joranderaaff/portal-turret-v4/README.md

# Portal Turret v4

A Portal-style turret powered by an ESP32-S3 (Lolin S3 Mini). It detects people with a mmWave radar, opens its wings, extends its guns and tracks targets, complete with sound and lights.

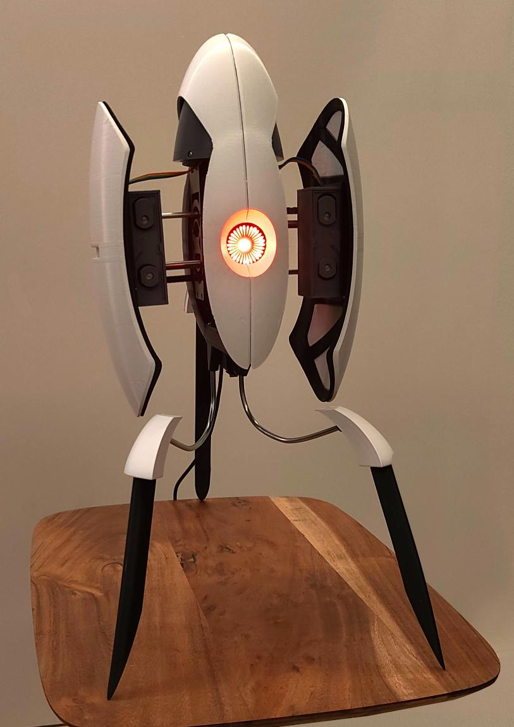
[picture p1: images/photo.jpg]
Portal Turret




## Repository layout

| Folder | Contents |
| --- | --- |
| `src/` | Firmware (PlatformIO, Arduino framework) |
| `data/` | LittleFS image: audio clips and web UI |
| `3d/` | 3D model (`model.step`) |
| `gerber/` | PCB manufacturing files (MainBoard, DaughterBoard) |
| `images/` | Build guide photos |

## Bill of materials

### Printing
- PLA (Or other material) in white, black and optionally transparent.

### Electronics
- Lolin Wemos S3 Mini
- 4x SG90 180 servo
- 2x SG90 360 servo
- LD2450 Radar Sensor
- ADXL345 Digital 3-axis Accelerometer Module
- MAX98357 Audio amp
- 2x OH49E Hall Effect Sensor - SS49E compatible
- SN74AHCT125N 4-channel Level Converter
- SK6812 Digital 5050 RGB LED Ring
- 5x WS2812 5mm LED
- Small rocker switch
- USB C Breakout Board, 12 * 15 * 1.6mm
- 2x 100nF Ceramic Capacitor 
- 1x 100uF 25V Elektrolytic Capacitor

### Motion
- 604ZZ Ball Bearing - 4x12x4mm
- MYT LM6LUU Linear Ball Bearing - 2 pieces (35mm length)
- 4mm steel rod
- 6mm steel rod

### Cables
- JST PH crimp set OR JST PH headers and pre-crimped JST PH cables
- Pin headers

### Fasteners
- 2mm wood screws
- Super Glue

## Steel Rod Sizes

For the 4mm rods:
- 1x 150mm (enforcing the rear leg)
- 2x 55mm (enforcing the front legs)
- 2x 60mm (wings)
- 1x 43mm (x-axis axle)
- 1x 20mm (z-axis bottom axle)
- 1x 10mm (z-axis top axle)

The bended rods for the legs do not have a very precise length. It's best to bend and cut to length after bending, as this makes the process of getting the correct shape a lot easier.

For the 6mm rods:
- 2x 60mm (wings)

## 3D printing

STEP file contains all 3D printed parts.

[All STL files can be found here.](https://www.printables.com/model/1892132-portal-turret-mk-ii)

## Electronics

Gerber files are included. Order from your favorite PCB manufacturer.

### Pinout

ESP32-S3 GPIO numbers, defined in `src/pins.h`.

| Function | GPIO |
| --- | --- |
| Left / right gun servo | 1 / 2 |
| Left / right wing servo | 4 / 5 |
| Rotate X / Z servo | 6 / 7 |
| Left / right hall sensor (analog) | 8 / 9 |
| Eye LED ring (center) / left gun LEDs / right gun LEDs | 14 / 15 / 16 |
| Radar (ESP RX / ESP TX) | 17 / 18 |
| ADXL345 I2C (SDA / SCL) | 35 / 36 |
| Audio amp I2S (DIN / BCLK / LRCLK) | 10 / 11 / 12 |

### Power

The turret runs on 5 V, from the USB-C board or the power connector. The servos, LED ring, audio amp and radar all share it, so use a supply that can deliver at least 2 A. That figure is a rule of thumb for six SG90 servos plus the LEDs, not a measured value.

## Preperation

The 180 degree servos might not be centered when you purchase them. Make sure you to do this with a servo tester or writing a small Arduino sketch that centers your servos. If you don't have an Arduino board to do this, you could even use the Wemos in a breadboard and use some wires to hook up a servo to calibrate them.

Use the hall sensor to find out what the north and south pole of your magnets are. You'll need to know this to make sure you insert them correctly later in the build.
Again you can use the Wemos to test. Using a breadboard, hook up the sensor to 3.3V, Gnd and one of the analog pins. Read the analog value. When the north pole faces the sensor, the value should increase. If it's the south pole, it should decrease.

## Assembly guide

Here's raw screenshots. Explicit information comes later.

### X axis

| Notes | Images |
| --- | --- |
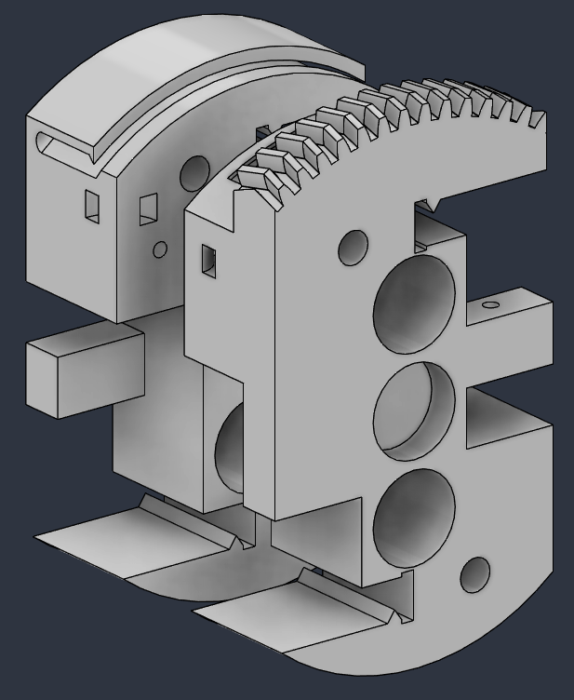
[picture p2: images/x_axis_001.png]
X axis 2
| Screw the two halves together. |  |
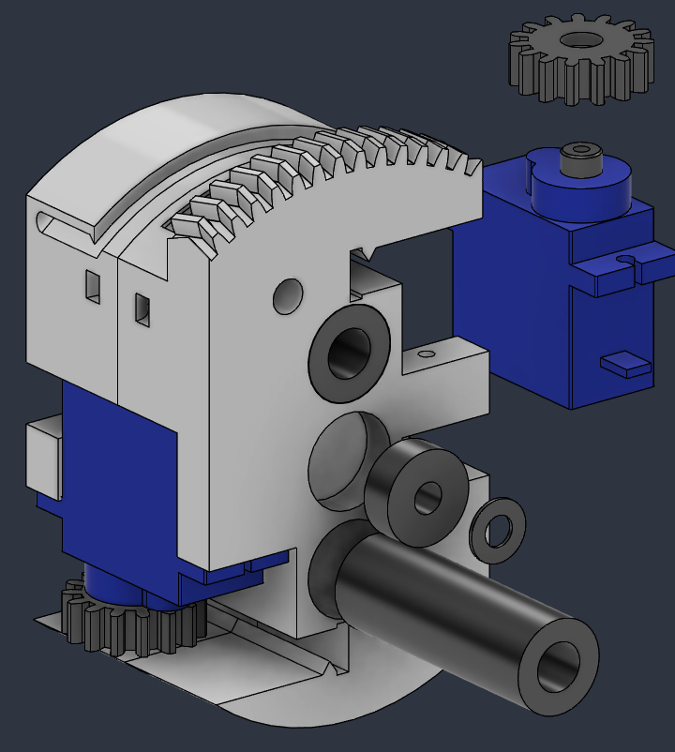
[picture p3: images/x_axis_002.png]
X axis 2
| Insert the LM6LUU and 604ZZ bearings. Screw the gears on the two 360 servos. |  |
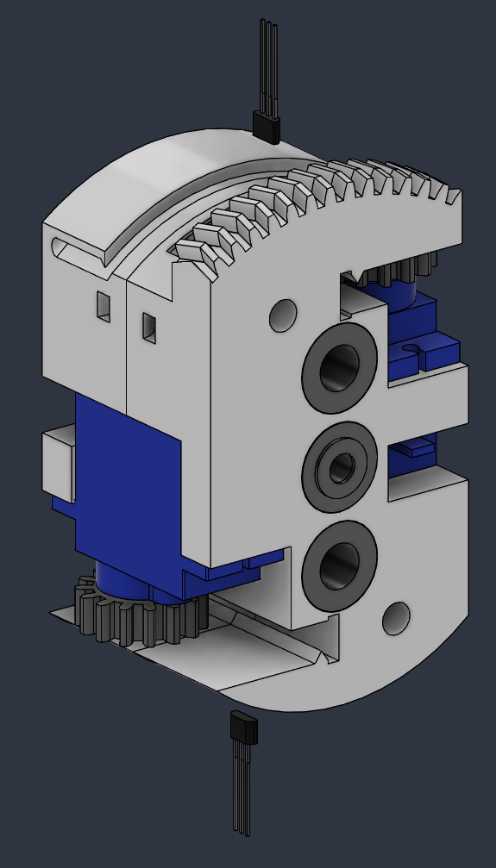
[picture p4: images/x_axis_003.png]
X axis 3
| Solder the wires to the hall sensors. Use shrink tubing to protect the leads. Insert the hall sensors into the slots. The beveled face is the front and should point towards the space where the rack gears will slide. |  | 
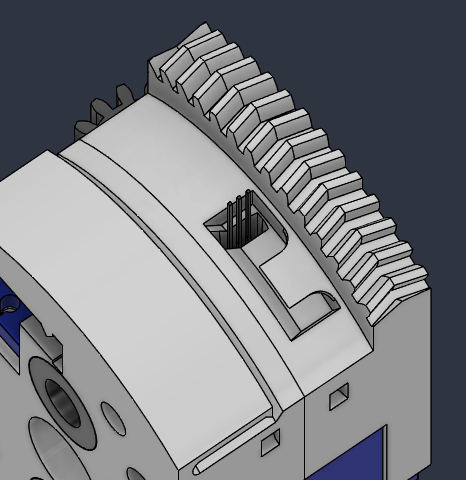
[picture p5: images/x_axis_004.png]
X axis 4
| Tuck the wires underneath the little lip. This should help with keeping the hall sensors in place. If they don't want to stay seated, a drop of superglue should help. |  | 

### Z axis
| Notes | Images |
| --- | --- |
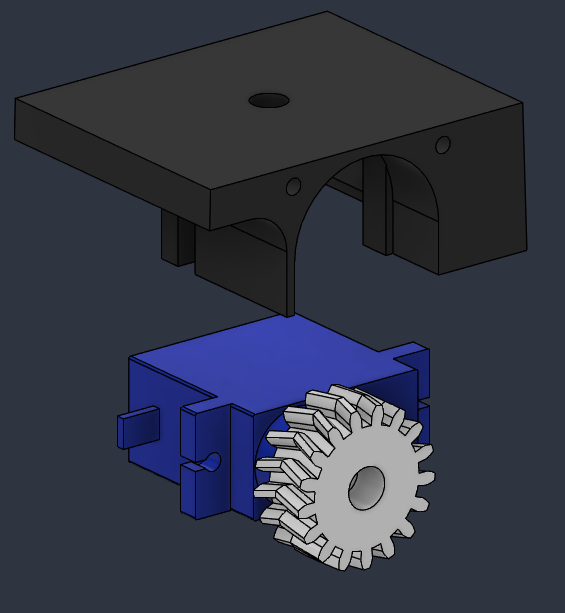
[picture p6: images/z_axis_001.png]
Z axis 1
| Screw on the X Axis gear on a 180 servo. Slide it in place and use the channels to screw it down. |  |
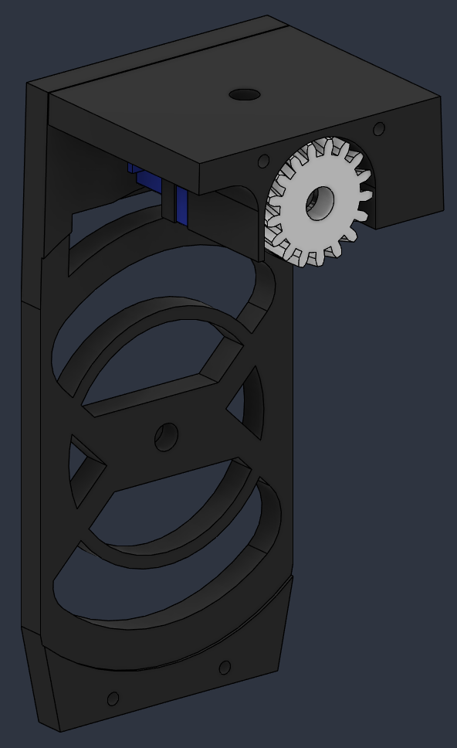
[picture p7: images/z_axis_002.png]
Z axis 2
| Attach one side. |  |
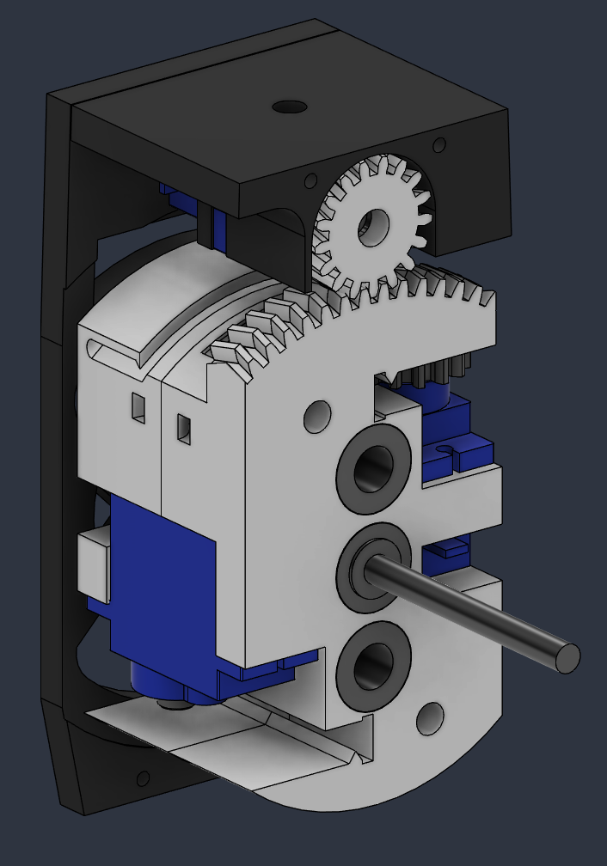
[picture p8: images/z_axis_003.png]
Z axis 3
| Slide a 4mm rod through the X axis. Add a 4mm shim on both sides. There is a slot in the frame where the rod should fit. |  |
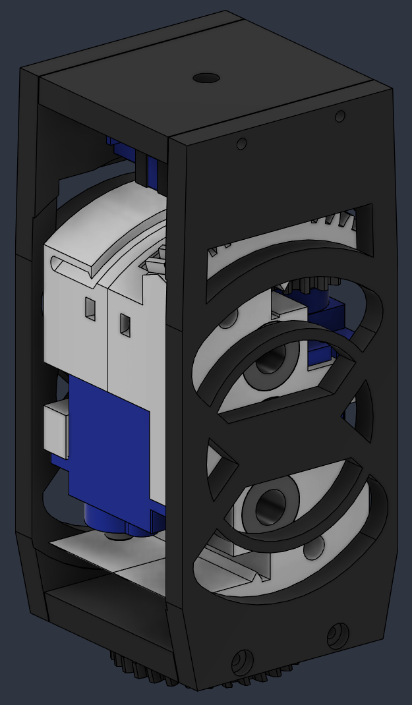
[picture p9: images/z_axis_004.png]
Z axis 4
| Scew on the bottom and the other side. |  |
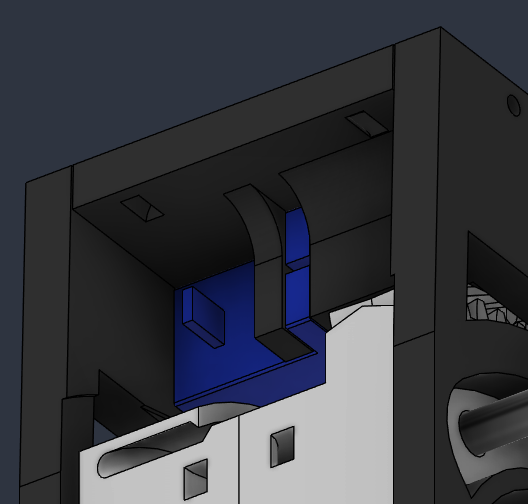
[picture p10: images/z_axis_005.png]
Z axis 4
| Use a ziptie to manage all cables. It should hold the following wires: 2 Hall sensors, 2 Wing servos, X Axis servo. |  |

### Bottom
| Notes | Images |
| --- | --- |
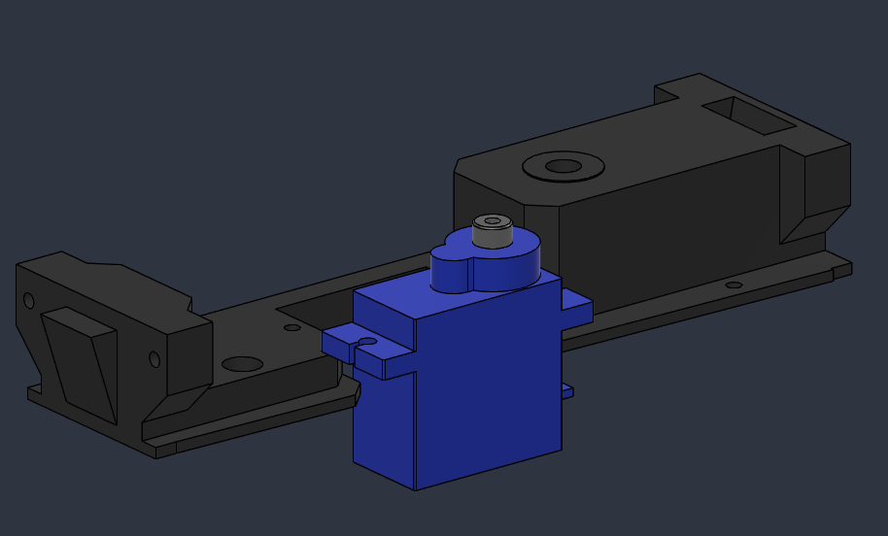
[picture p11: images/bottom_001.png]
Bottom 2
| Slide a 180 servo in the mount and screw it secure |  |
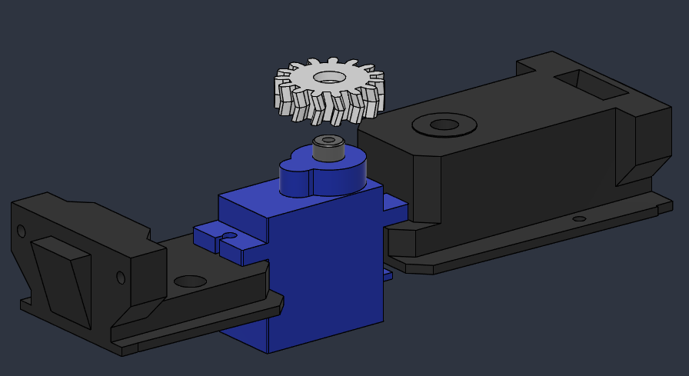
[picture p12: images/bottom_002.png]
Bottom 2
| Screw on the Z Axis gear. |  |
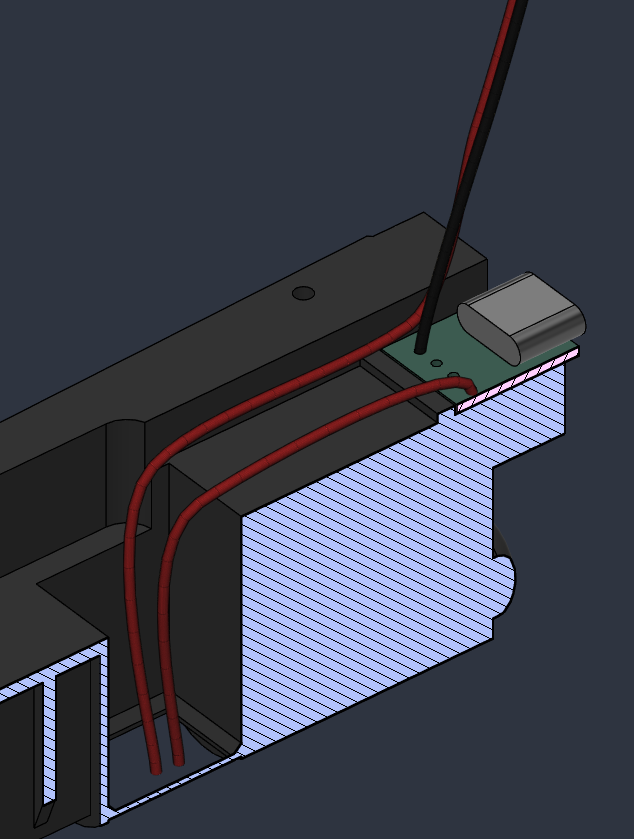
[picture p13: images/bottom_003.png]
Bottom 2
| The USB-C board should be glued into place. If you can't get a solid connection with glue, a tiny screw with some heatshrink could be screwed through the D- slot. Make sure the screw does not short D- to ground, hence the heatshrink tubing. Run the wires through the bottom. Make sure to leave enough to route the wires and attach the JST connector. |  |
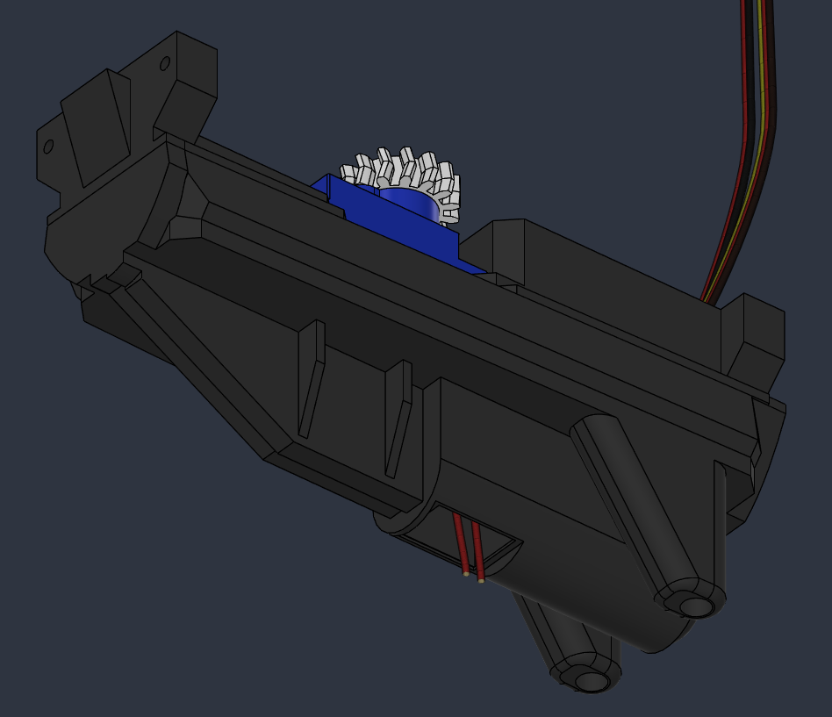
[picture p14: images/bottom_004.png]
Bottom 2
| Route the two 5V wires to the bottom. One should come from the USB board, the other should go to your power connector. |  |
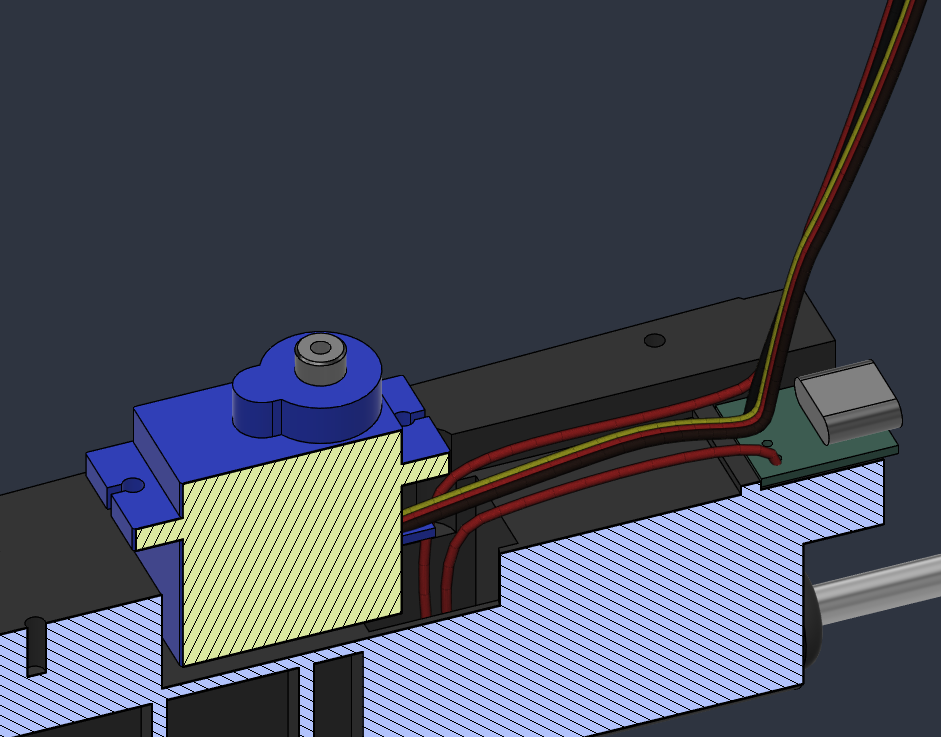
[picture p15: images/bottom_005.png]
Bottom 2
| The servo wires should also be run through the same channel to go up in the back. |  |
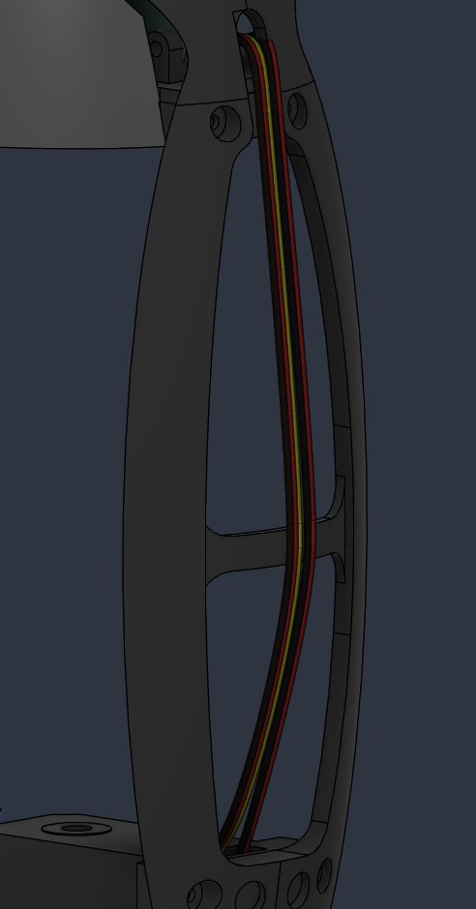
[picture p16: images/bottom_006.png]
Bottom 2
| Run both the servo and power wires through the gantry. Use the little brace to keep them out of the way from the gantry.  |  |

### Eye
| Notes | Images |
| --- | --- |
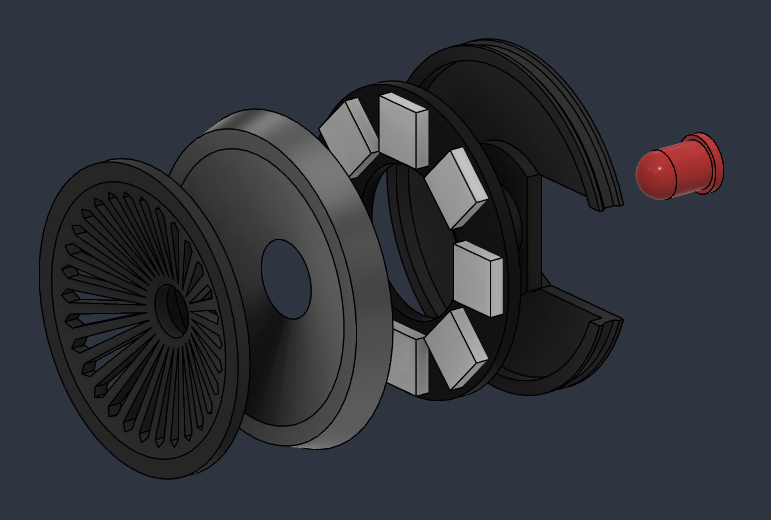
[picture p17: images/eye_001.png]
Eye 1
| Print the flat retina and mold. As PLA gets soft at relatively low temperatures, you can dunk it in boiling water and press it on the mold for the correct shape. Make sure to print the diffuser with very little top/bottom layers and walls, or use transparent filament. Glue in the LED ring and 5mm LED. Bend the 5V and Gnd legs of the LED to the pads of the ring and solder them together. The `D-in` leg should go to the `D-out` pad. Run 3 wires to the `D-in` `5V` and `Gnd` pads of the LED Ring. Keep enough length to run it through the turret. Add a JST connector when you're sure you have enough length. |  |

### Gantry

| Notes | Images |
| --- | --- |
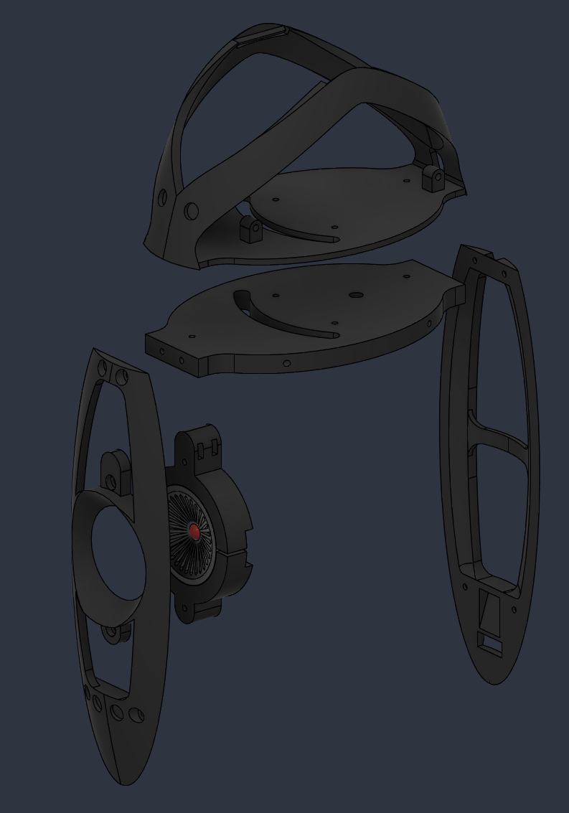
[picture p18: images/gantry_001.png]
Gantry 1
| The gantry consists of 5 different pieces. This is done so you can print with little to no support material. The eye should click in place and stay there without any glue. |  |
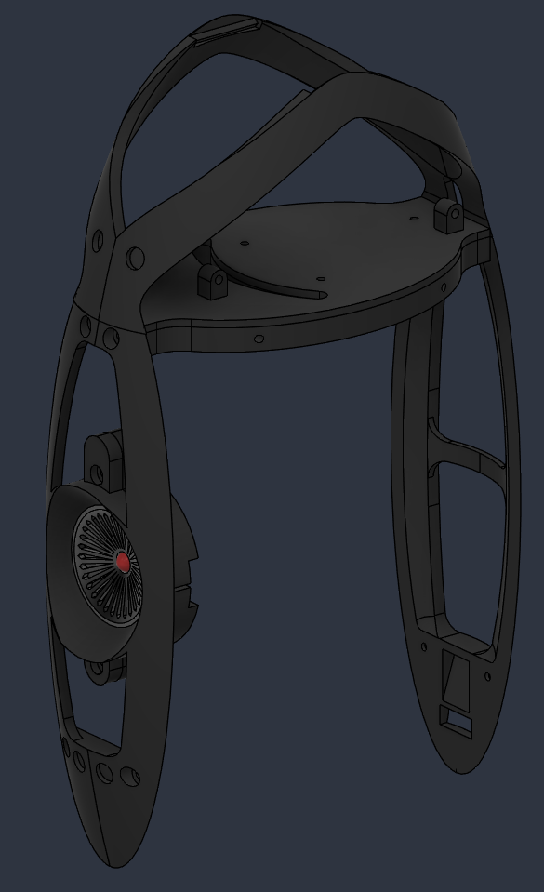
[picture p19: images/gantry_002.png]
Gantry 2
| The whole gantry should screw together and give enough rigidity for the build. |  |
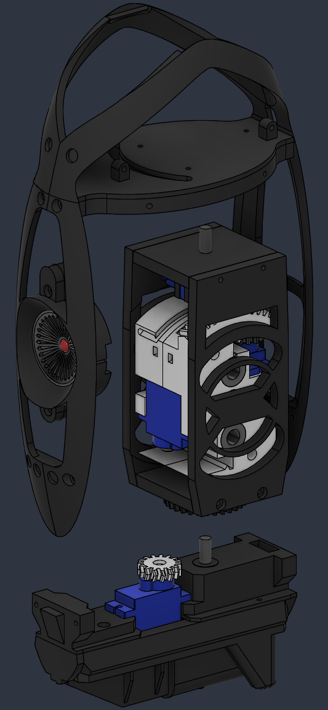
[picture p20: images/gantry_003.png]
Gantry 3
| Slide in the gantry and bottom. Make sure to not rotate your servo when assembling, otherwise you'll risk a very big offset in angle. You can calibrate small offsets in the settings. |  |
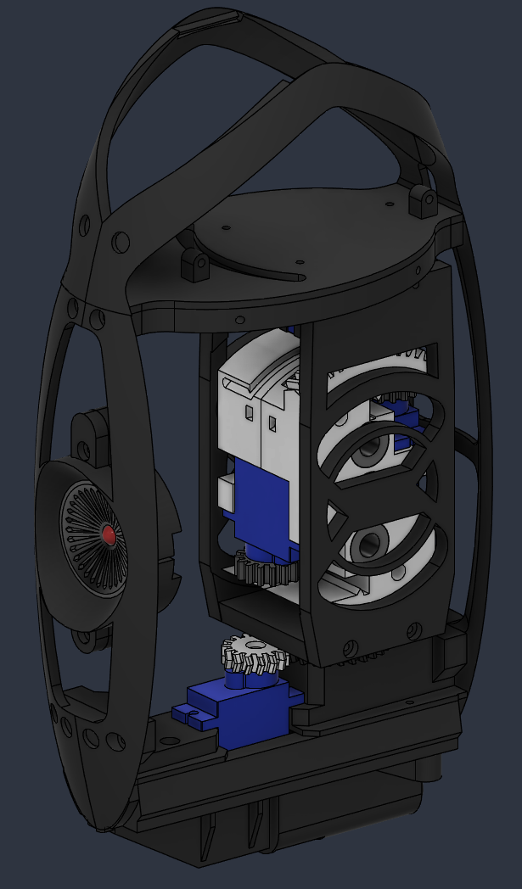
[picture p21: images/gantry_004.png]
Gantry 3
| Screw in the last screws on the front and back of the gantry to finish the motion system. |  |

### Guns

| Notes | Images |
| --- | --- |
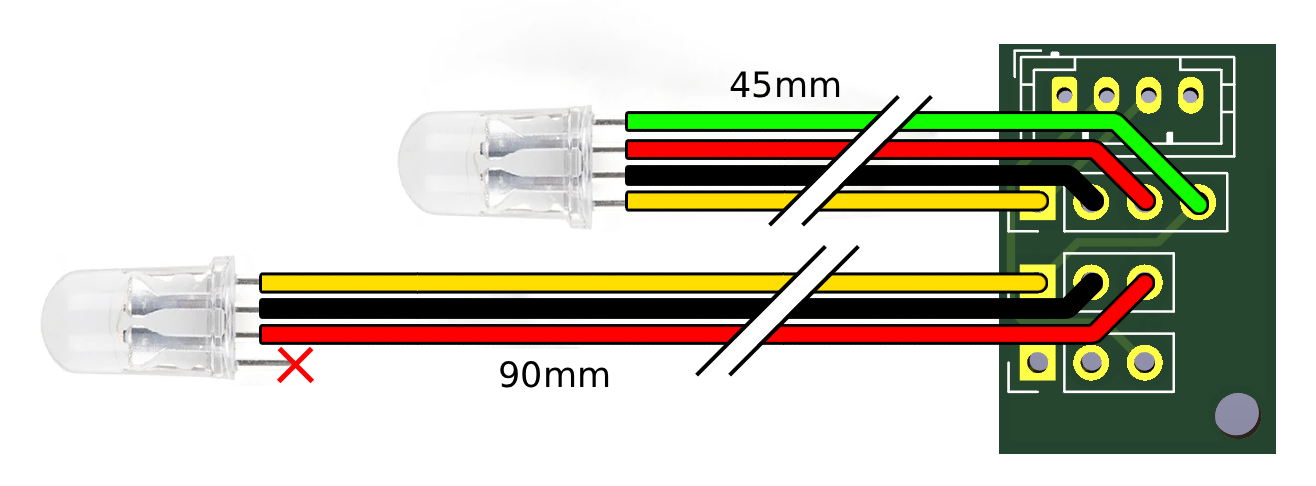
[picture p22: images/led_harness.png]
| Prepare the LED harness. You can either use JST connectors or solder directly to the board. Make sure you double check the pads of the board and the legs of your LEDs. I've found that different brands can have a different order in the legs. Please note that the `Data In` leg should go to the `Data In` pad, NOT the `Data Out` pad. |  |
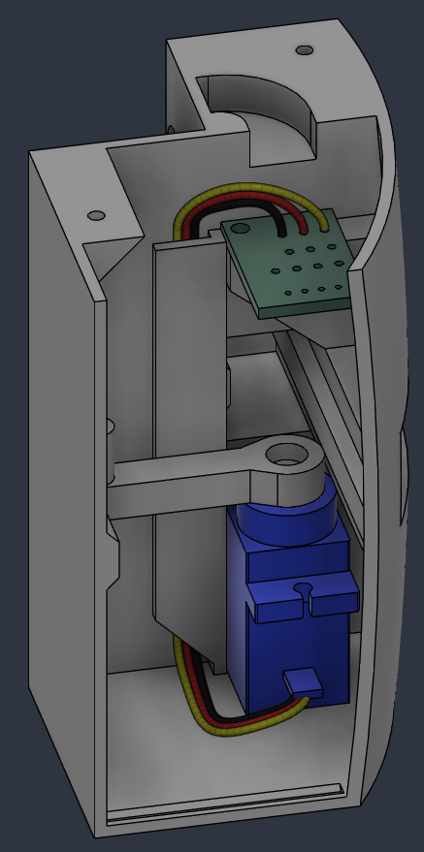
[picture p23: images/gun_001.png]
| Attach the lever to a 180 servo. The lever should be a friction fit. Insert it into the gun casing and run the wire as shown. Note that the LED harness is not shown here, but should already be attached to the board. |  |
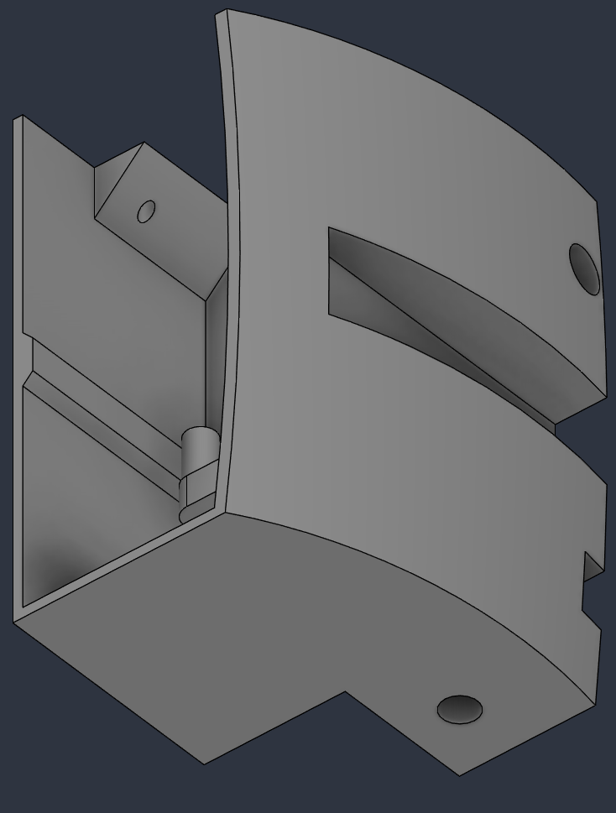
[picture p24: images/gun_002.png]
| There's a hole in the bottom to fasten the servo with a screw. |  |
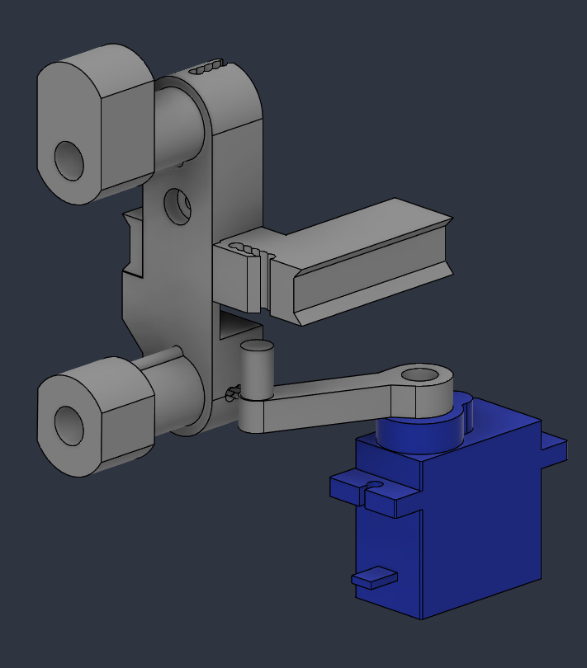
[picture p25: images/gun_003.png]
| Insert the barrels into their housing. This should be a friction fit. The housing screws on the part with one screw. |  |
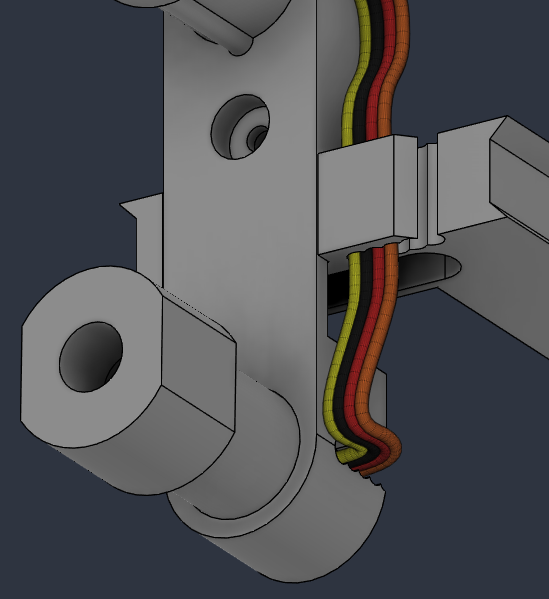
[picture p26: images/gun_004.png]
| Slide in the bottom LED and run the wires to the side and through the clamp in the front. |  |
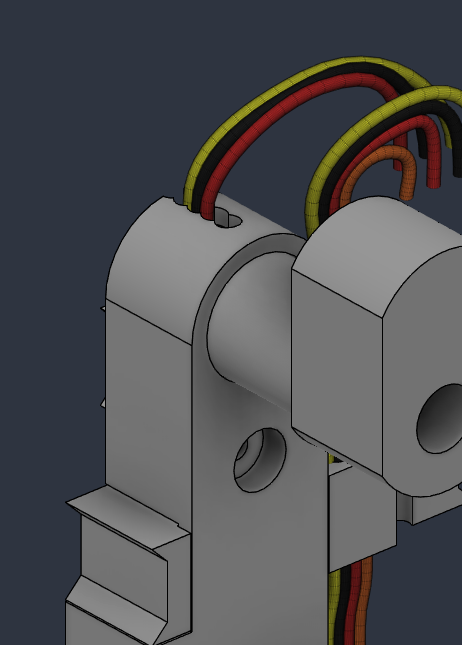
[picture p27: images/gun_005.png]
Gun 3
| Slide in the top LED and run the wires out the top. |  |
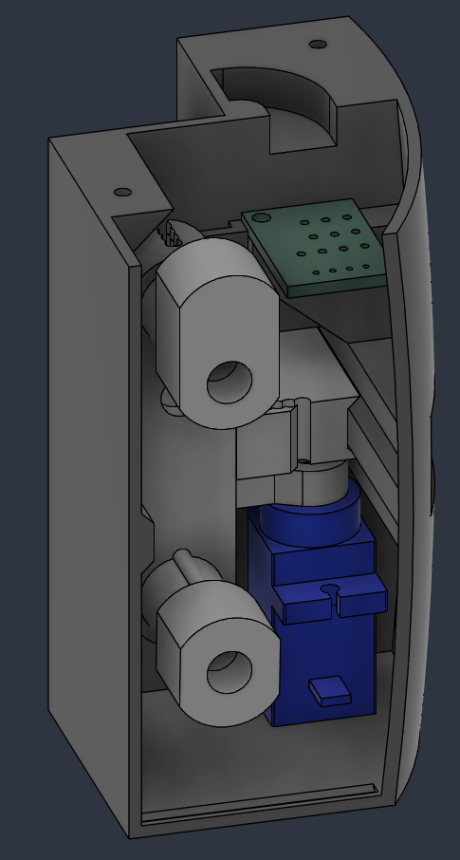
[picture p28: images/gun_006.png]
Gun 4
| Rotate the lever so it points forward. |  |
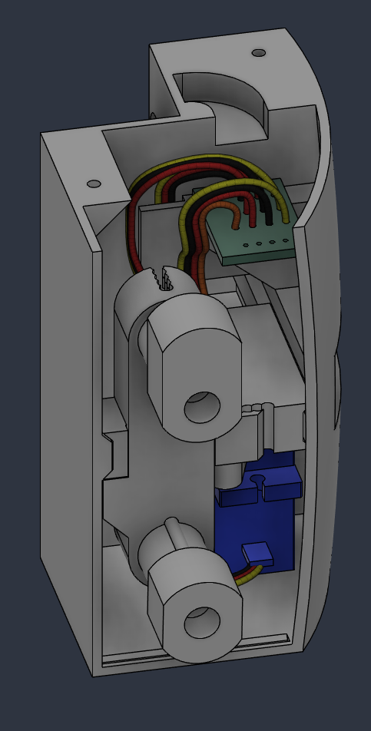
[picture p29: images/gun_007.png]
Gun 5
| Carefully slide the barrels over the lever. You might need to bend the housing to get it in place. Note that the pictures shows the wires outside of the clamps, this is a render error. |  |
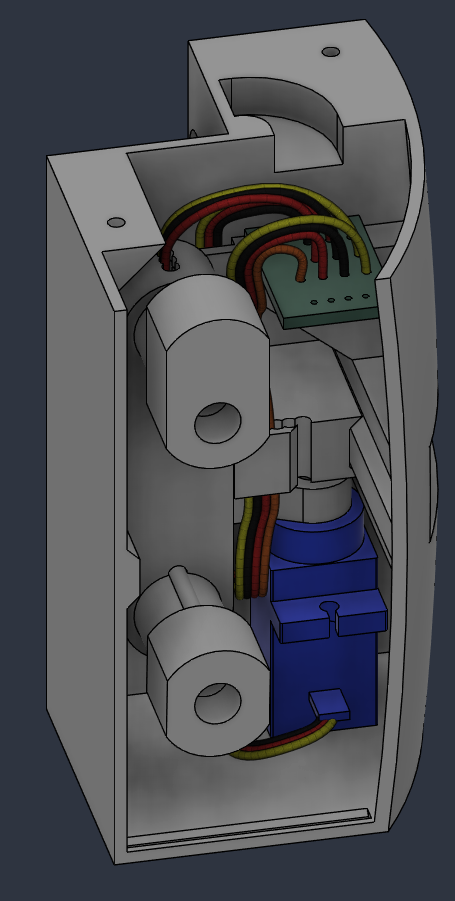
[picture p30: images/gun_008.png]
| Slide the barrels back into the housing. They should slide easily. If not, try to move the lever by hand. If the barrels don't move, check the clearance of your parts. |  |
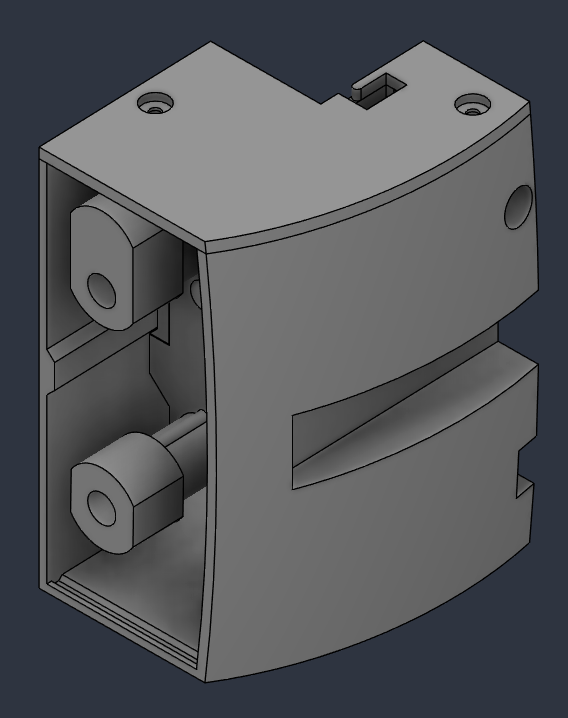
[picture p31: images/gun_009.png]
| The top can now be screwed on. |  |
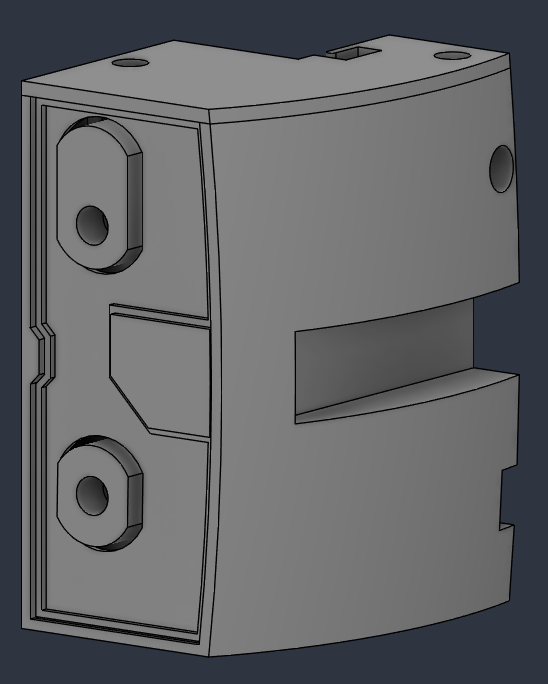
[picture p32: images/gun_010.png]
| The front plate should click in place. |  |

### Wings

| Notes | Images |
| --- | --- |
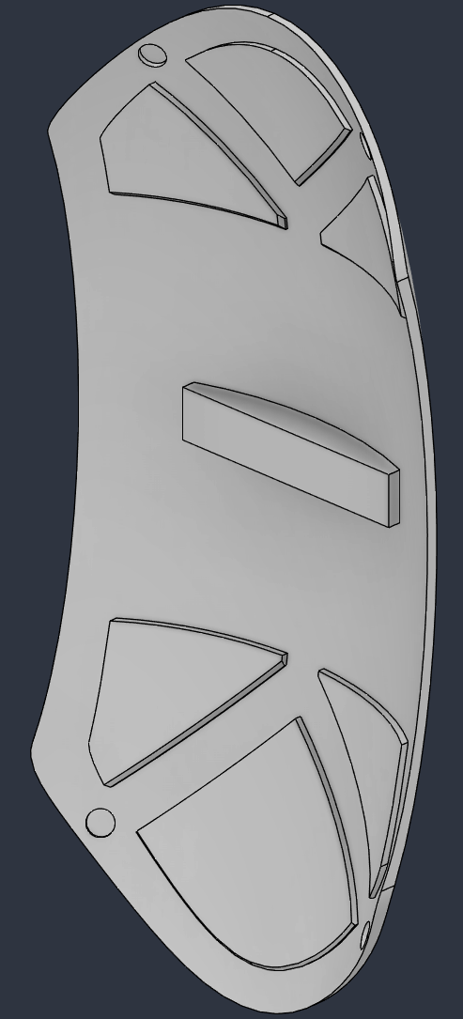
[picture p33: images/wing_001.png]
Wing 1
| Add 1mm magnets to the slots of the wing. Mind the polarity! |  |
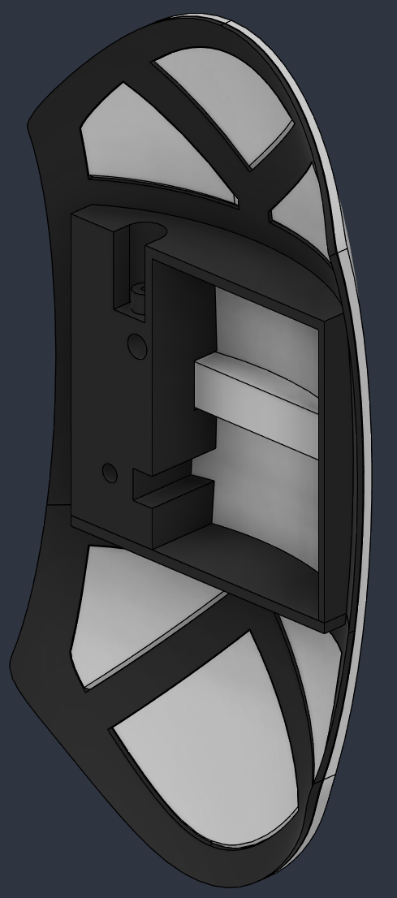
[picture p34: images/wing_002.png]
Wing 2
| Add 1mm magnets to the slots of the the wing frame. Mind the polarity! |  |
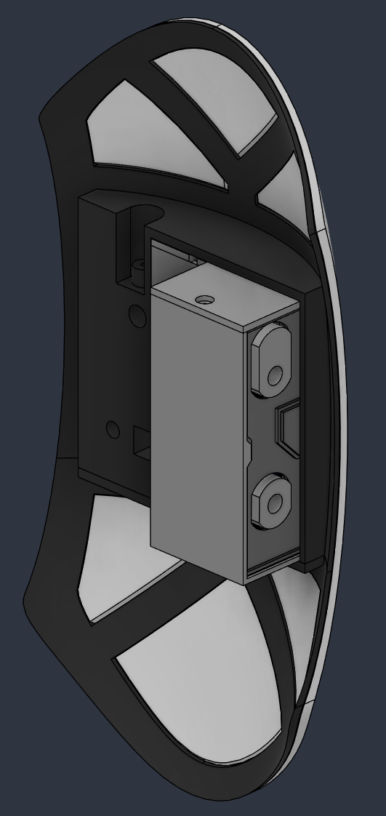
[picture p35: images/wing_003.png]
Wing 3
| The gun should slide in the designated slot. |  |
| Insert the magnets in the rack gear. They should click in place, but a drop of glue helps. Make sure to mind the polarity!| Wing 4 |
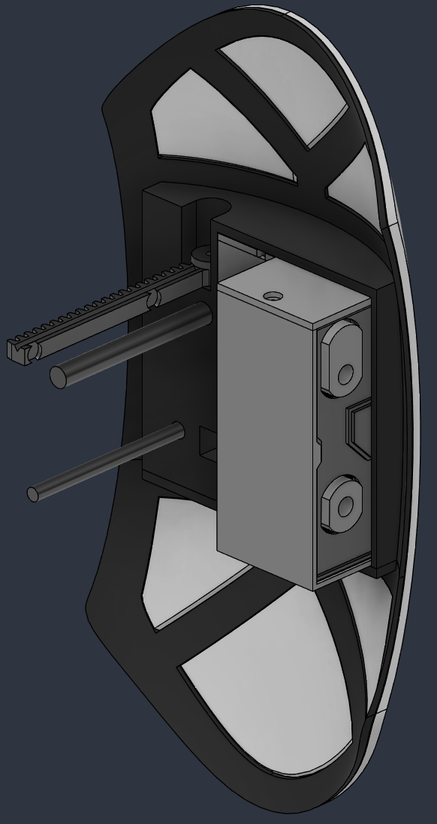
[picture p36: images/wing_005.png]
Wing 4
| Attach the rack gear and secure it with a screw. Glue in the 4mm and 6mm steel rods. |  |

### PCB, Speaker and Radar

| Notes | Images |
| --- | --- |
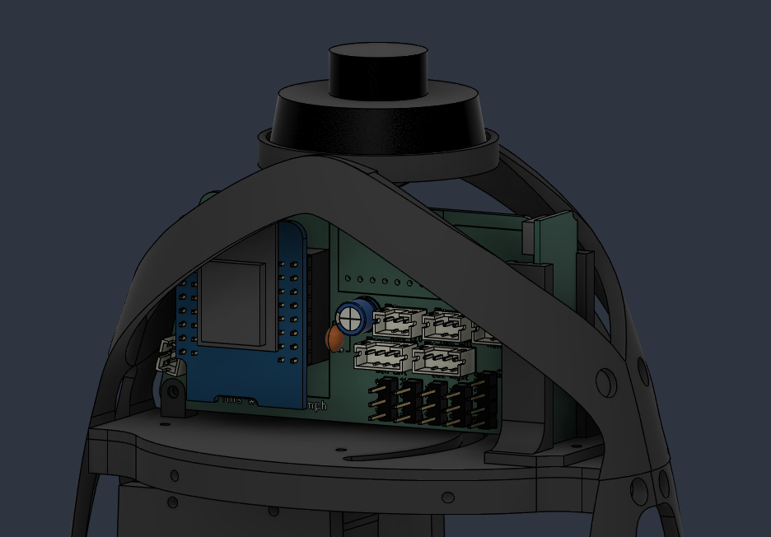
[picture p37: images/top_001.png]
| PCB, Speaker and Radar should be mounted in the top. Note that the ADXL and Amplifier are missing in this picture. They should be soldered on the PCB. |  |
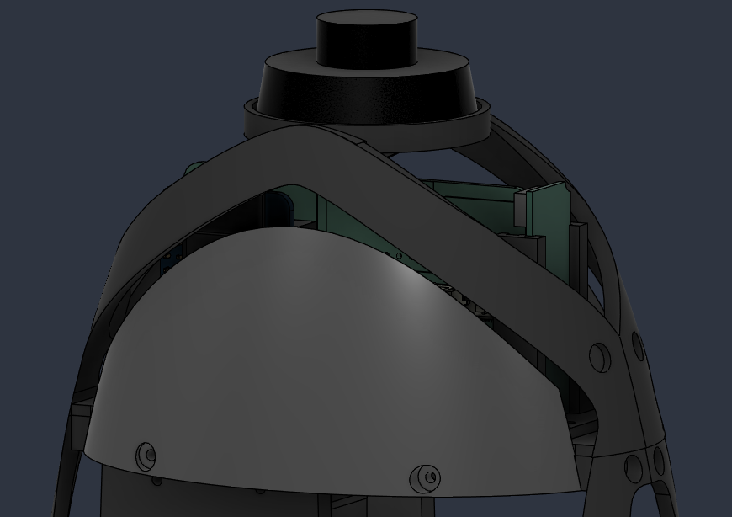
[picture p38: images/top_002.png]
| There are optional panels to cover the electronics. |  |

### Leg
| Notes | Images |
| --- | --- |
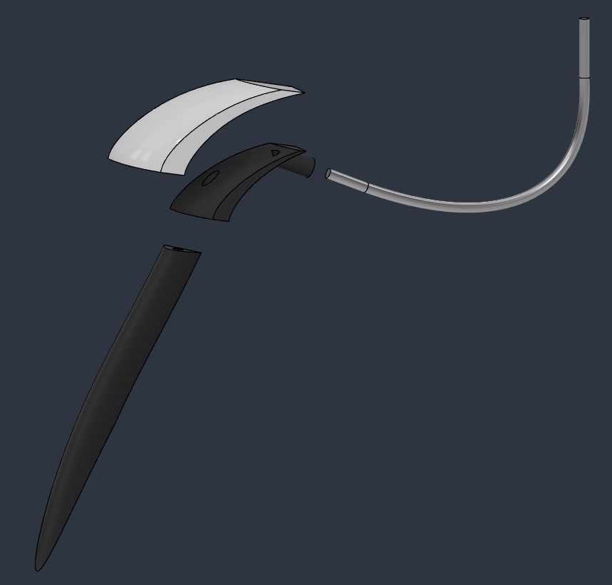
[picture p39: images/leg_001.png]
Leg 1
| The legs should be glued together. Use a piece of 4mm rod to strengthen the joint between the "leg" and the "knee" |  |

## Firmware

You can build the firmware with <a href="https://code.visualstudio.com/">Visual Studio Code</a> together with the PlatformIO plugin.

Use the following two commands to flash your Wemos:



Or use these commands if you prefer working in the terminal.

```bash
pio run                # build
pio run -t upload      # flash firmware
pio run -t uploadfs    # flash LittleFS (audio + web UI)
```

Flash both on a new turret: the firmware first, then the filesystem. Run `uploadfs` again whenever something in `data/` changes.

OTA updates are possible once the turret is on your network (`turret.local`) or in its own access point ("Portal Turret", `192.168.4.1`). While an update runs the turret stops moving and the audio pauses.

### First start and WiFi

1. On the first start, and whenever the turret can't join its saved network, it opens the WiFi network "Portal Turret".
2. Connect to it. The WiFi setup page opens by itself, or browse to `http://192.168.4.1`.
3. Pick your network and enter the password. The turret restarts, joins your network and is reachable at `http://turret.local`.
4. If the saved network is out of reach (for example the router is still booting after a power cut), the "Portal Turret" network returns. The turret tries the saved network again every minute, as long as nobody is connected to its access point, and closes the access point once it is back on your network.

The access point is open by default. To protect it, enter 8 or more characters as "Access Point Password" on the Settings page and restart the turret. The access point keeps that password when you reset the settings to their defaults, so it can't fall back to open by accident.

### Web interface

| Page | What it does |
| --- | --- |
| Home | Live radar, accelerometer graphs and the turret's message log. |
| Control | Start the turret by hand. |
| Remote | Aim with a joystick, open/close the wings, fire, party mode. |
| Settings | All settings, Restart, reset to defaults, enable multitarget on the radar. |
| WiFi | Pick the network the turret joins. |
| Diagnose | Move every servo raw, read the hall sensors, test LEDs and audio. |

Settings take effect as soon as you save them. Only the network settings (WiFi, access point password) need a restart: use the Restart button on the Settings page.

Remote and Diagnose stop all automatic behaviour. Press Resume on either page to hand control back: the turret centers the gantry, closes the wings and starts over. A power cycle does the same.

## Calibration

When connecting to the web portal, there is a `Settings` page. Most of these settings are tweaked already, but you might need a few to get your turret to work perfectly:
You can use the `Diagnose` page to find the exact values you want to use (the hall sensor readings help with Gun Hall Min/Max).

- Angle offset X: Use this to make sure the wings are pointing forward when the turret is idle.
- Angle offset Z: Use this to center the gantry when the turret is idle.
- Gun Hall Min/Max: The treshold of the hall sensor that triggers the Open/Closed state of the wings.

The other parameters are less important, but you can play around with them to suit your needs.
