joranderaaff/portal-turret-v4/images/gantry_005.png

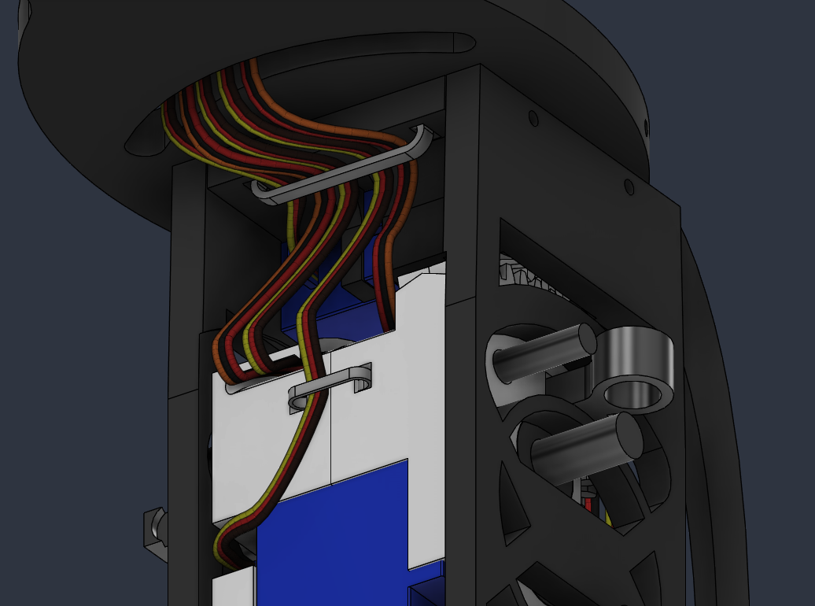
images/gantry_005.png
