joranderaaff/portal-turret-v4/images/gantry_006.png

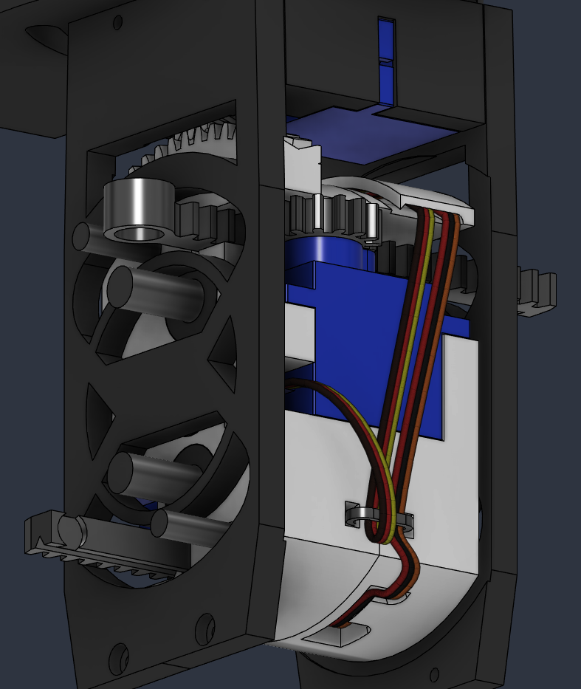
images/gantry_006.png
