joranderaaff/portal-turret-v4/images/x_axis_005.png

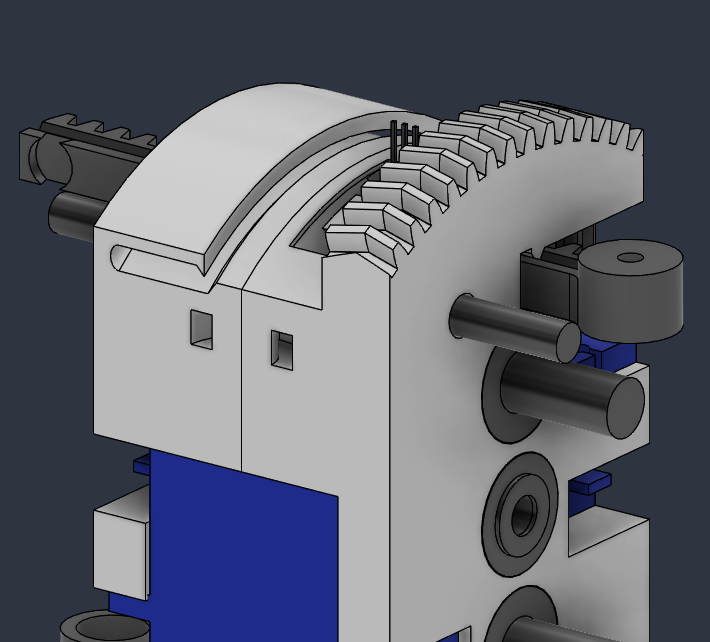
images/x_axis_005.png
