joranderaaff/portal-turret-v4/3d/model.step

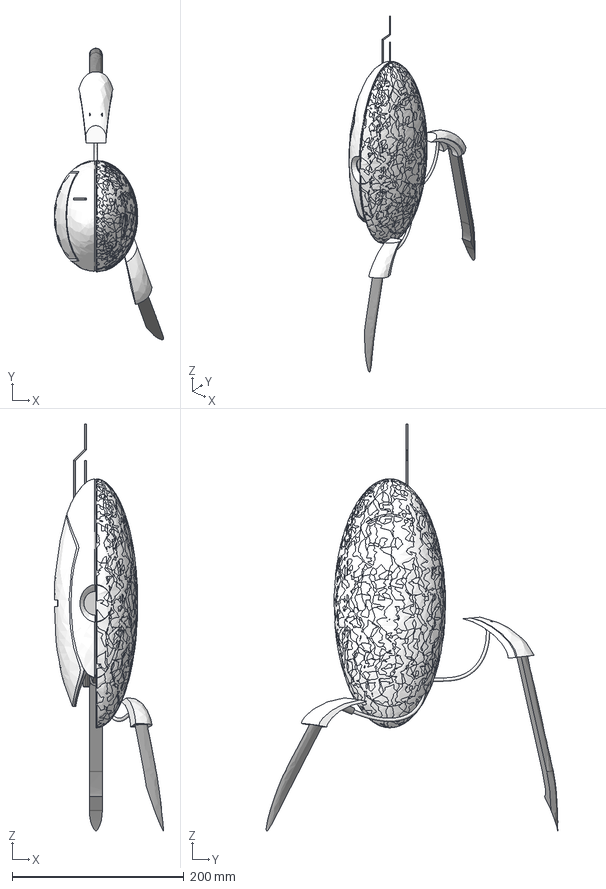
[picture p43: CAD file, 2026-10-19]
3d/model.step
127.3 x 339.5 x 473.8 mm
BarrelSlider
servo x 5
splined-drive x 5
horn x 5
Front
SliderPin
Barrels
CustomSupport
WingSupports
ShellLeft
ShellRight
servo(Mirror)
splined-drive(Mirror)
horn(Mirror)
BarrelSlider(Mirror)
Front(Mirror)
Barrels(Mirror)
SliderPin(Mirror)
CustomSupport (1)
Bearing
Bearing (1)
6mm Shaft
4mm Shaft
6mm Shaft (1)
4mm Shaft (1)
Mount
Bearing (2)
Shim
RackGear
Gear x 2
RackGear(Mirror)
49E Hall Effect Sensor x 2
ServoMount (1)
ServoMount
ZAxisBottom
ZAxisGear
USB-C Port
White (1)
Black (1)
Black
White
PinHeader_1x03_P254mm_Vertical x 4
JST_B4B_PH_K x 3
C_Disc_D51mm_W32mm_P500mm x 2
JST_B3B_PH_K
wemos_d1_mini_light_1
PinHeader_2x08_P254mm_Vertical x 2
PinSocket_2x08_P2.54mm_Vertical_2 x 2
PinHeader_1x04_P254mm_Vertical
JST_B2B_PH_K
CP_Radial_D63mm_P250mm
Portal Turret V4_silkscreen
Portal Turret V4_PCB
MMWaveRadar
Speaker
Retina
RedLED
Diffuser
RetinaFlat
Mold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
