joranderaaff/portal-turret-v4/(list of files, cad)

Other CAD files:
3d/Wires.blend
