joranderaaff/portal-turret-v4/src/states/StateMachine.cpp

#include "states/StateMachine.h"

void StateMachine::Initialize(Turret &turretIn) {
  turret = &turretIn;
  bootState.Initialize(this, turretIn);
  idleState.Initialize(this, turretIn);
  activateState.Initialize(this, turretIn);
  disengageState.Initialize(this, turretIn);
  manualState.Initialize(this, turretIn);
  remoteState.Initialize(this, turretIn);
  firingState.Initialize(this, turretIn);
  searchState.Initialize(this, turretIn);
  tippedOverState.Initialize(this, turretIn);
  panicState.Initialize(this, turretIn);
}

void StateMachine::GoToState(StateId nextStateId) {
  if (currentState) {
    currentState->OnDeactivate();
  }

  currentState = GetState(nextStateId);
  currentStateId = nextStateId;

  if (currentState) {
    //turret->logger.Info("State %d", (int)nextStateId);
    currentState->OnActivate();
  }
}

void StateMachine::RequestStart() {
  if (currentStateId == StateId::Idle) {
    GoToState(StateId::Activate);
  }
}

void StateMachine::RequestDiagnose(const DiagnoseCommand &command) {
  if (currentStateId != StateId::Manual) {
    GoToState(StateId::Manual);
  }
  manualState.Execute(command);
}

void StateMachine::RequestRemote(const RemoteCommand &command) {
  if (currentStateId != StateId::Remote) {
    GoToState(StateId::Remote);
  }
  remoteState.Execute(command);
}

BaseState *StateMachine::GetState(StateId stateId) {
  switch (stateId) {
  case StateId::Booting:
    Serial.println("Bootstate");
    return &bootState;
  case StateId::Activate:
    Serial.println("ActivateState");
    return &activateState;
  case StateId::FiringState:
    Serial.println("FiringState");
    return &firingState;
  case StateId::SearchState:
    Serial.println("SearchState");
    return &searchState;
  case StateId::Disengage:
    Serial.println("DisengageState");
    return &disengageState;
  case StateId::Idle:
    Serial.println("IdleState");
    return &idleState;
  case StateId::Manual:
    Serial.println("ManualState");
    return &manualState;
  case StateId::Remote:
    Serial.println("RemoteState");
    return &remoteState;
  case StateId::TippedOver:
    Serial.println("TippedOverState");
    return &tippedOverState;
  case StateId::Panic:
    Serial.println("PanicState");
    return &panicState;
  }
  return nullptr;
}

void StateMachine::Update(ulong deltaTime) {
  if (!currentState) {
    return;
  }

  StateId next;
  if (currentState->CheckInterrupt(next)) {
    GoToState(next);
    return;
  }
  currentState->Update(deltaTime);
}
