joranderaaff/portal-turret-v4/src/states/IdleState.h

#pragma once

#include "BaseState.h"

class IdleState : public BaseState {
public:
  void OnActivate() override;
  void Update(ulong deltaTime) override;
  bool CheckInterrupt(StateId& next) override;
};
