joranderaaff/portal-turret-v4/src/audio/GunShotAudio.h

#include <Arduino.h>

const PROGMEM uint8_t samples[] = {
0x0B, 0x00, 0x54, 0x00, 0x23, 0x00, 0x00, 0x00, 0x0F, 0x00, 0x41, 0x00, 0x54, 0xFF, 0x49, 0x00, 
0x82, 0xFF, 0x38, 0x00, 0x93, 0xFF, 0xED, 0xFF, 0x30, 0xFF, 0x0A, 0x00, 0x30, 0x00, 0x8F, 0xFF, 
0x02, 0x01, 0x2A, 0xF8, 0xA4, 0xF0, 0xEB, 0xE9, 0xD7, 0xE4, 0x85, 0xE9, 0x0F, 0xED, 0xA9, 0xEB, 
0xE9, 0xF0, 0xD8, 0xEC, 0x2B, 0xE4, 0xFB, 0xF7, 0x68, 0xF4, 0xAC, 0x02, 0xA3, 0xFF, 0xCE, 0xFA, 
0x35, 0xF8, 0xBB, 0x04, 0x1A, 0x00, 0x62, 0xE6, 0xE0, 0x03, 0x86, 0xF2, 0x7B, 0x4B, 0x2C, 0x05, 
0x59, 0x2D, 0xF2, 0x54, 0x4C, 0xF1, 0x11, 0xFE, 0x11, 0xF4, 0x05, 0x33, 0x77, 0x38, 0x0F, 0x18, 
0xF4, 0xF3, 0x0C, 0xE0, 0x76, 0xAA, 0xB5, 0xEF, 0x46, 0xD2, 0x57, 0xAD, 0x95, 0xA3, 0x0C, 0xAE, 
0x16, 0xAF, 0xBB, 0xAD, 0xBE, 0xC4, 0x57, 0xBA, 0x4A, 0xB1, 0xD7, 0xB2, 0xAA, 0xD6, 0x5A, 0xE3, 
0x50, 0x1F, 0xD1, 0x14, 0x0A, 0x21, 0xDF, 0xC4, 0x32, 0xF7, 0xED, 0x02, 0xB9, 0xFE, 0xBC, 0x06, 
0x64, 0xFA, 0x70, 0x30, 0xD4, 0x1A, 0x97, 0x3B, 0x70, 0x09, 0x9C, 0xCE, 0xAD, 0xF0, 0x25, 0x07, 
0x05, 0x0B, 0xB2, 0x20, 0x7E, 0x28, 0x52, 0x27, 0x35, 0x3E, 0xDF, 0x0F, 0x6C, 0xF7, 0x9F, 0x2E, 
0xC0, 0x29, 0xDC, 0x34, 0xF1, 0x1B, 0xD0, 0x2C, 0x10, 0xE0, 0xBB, 0x9F, 0xDD, 0xCA, 0x7D, 0xCD, 
0x15, 0xA7, 0x7A, 0x83, 0x48, 0xBC, 0x11, 0xB6, 0x64, 0xB9, 0x36, 0xC6, 0x67, 0x9C, 0xFD, 0xB5, 
0x79, 0xBE, 0x60, 0xB1, 0x2C, 0xA8, 0xDA, 0xC9, 0x6C, 0xB6, 0xD3, 0xD7, 0xB1, 0xDD, 0x44, 0xD3, 
0xEC, 0x18, 0x9C, 0xF2, 0xD2, 0xD1, 0xBE, 0xC9, 0x50, 0xED, 0x8D, 0xEA, 0x2C, 0x0E, 0x6C, 0x2C, 
0xD0, 0x26, 0xD7, 0x1C, 0xD5, 0x39, 0x04, 0x45, 0xB0, 0x42, 0xE8, 0x45, 0x31, 0x42, 0x98, 0x45, 
0x56, 0x41, 0xE3, 0x3E, 0xA2, 0x30, 0x95, 0x28, 0xD1, 0x06, 0xAC, 0xDE, 0x91, 0xE0, 0x1A, 0xF0, 
0x7C, 0xC3, 0xD3, 0xCC, 0xAB, 0xD2, 0xAD, 0xE4, 0x21, 0xEB, 0x7E, 0xF8, 0x26, 0xF5, 0x05, 0x05, 
0x09, 0x15, 0x38, 0x0E, 0xC0, 0x30, 0xB1, 0x1A, 0xFE, 0x0B, 0xC8, 0x09, 0x63, 0xFB, 0x57, 0xF9, 
0x6E, 0xF6, 0x7B, 0xD1, 0x64, 0xC7, 0x5E, 0xD3, 0x45, 0xDA, 0x8B, 0xAF, 0x78, 0xBA, 0xD0, 0xC0, 
0xCF, 0xB2, 0x20, 0xC4, 0x1B, 0xB7, 0x23, 0xC6, 0xAD, 0xD0, 0xAA, 0xDB, 0x5F, 0xDC, 0x22, 0xE2, 
0x2B, 0xDF, 0xF3, 0xDE, 0xD3, 0xE1, 0x03, 0xE2, 0xB5, 0xE1, 0x33, 0xE3, 0x73, 0xE2, 0xF6, 0xE0, 
0x7F, 0xD6, 0xA4, 0xD5, 0xB0, 0xD0, 0xB6, 0xD7, 0x83, 0xD8, 0xCA, 0xDB, 0xA6, 0xDF, 0xE6, 0xE2, 
0xA7, 0xEC, 0x41, 0x0B, 0x74, 0x24, 0x8D, 0xED, 0x97, 0x1B, 0x10, 0x0B, 0x28, 0x03, 0x4D, 0xFA, 
0xD4, 0xFF, 0x9E, 0xF7, 0x6A, 0xDA, 0xF9, 0xF3, 0x75, 0xE5, 0xBE, 0xFF, 0x0D, 0xF2, 0x10, 0xFC, 
0x3C, 0xF4, 0x61, 0xF6, 0x53, 0x09, 0xC4, 0x1B, 0x31, 0x03, 0x74, 0x15, 0x3A, 0x06, 0x1B, 0xFC, 
0x53, 0x13, 0xEA, 0xFD, 0x8D, 0xF6, 0x8A, 0xE5, 0xF8, 0xE8, 0x0C, 0xEB, 0x86, 0x09, 0xF7, 0x17, 
0x17, 0x20, 0x55, 0x21, 0x9B, 0x29, 0x21, 0x2F, 0x6D, 0x34, 0x62, 0x33, 0x25, 0x38, 0x62, 0x36, 
0xDA, 0x3A, 0x00, 0x3A, 0x8D, 0x43, 0xD2, 0x44, 0x25, 0x43, 0xFB, 0x3E, 0x6C, 0x56, 0x92, 0x56, 
0x90, 0x41, 0xF8, 0x4B, 0xE2, 0x14, 0x78, 0x0B, 0x98, 0xF7, 0x89, 0xF0, 0x8E, 0xF2, 0x57, 0xF3, 
0x5E, 0xF6, 0xA5, 0xF5, 0xA3, 0xF9, 0xF6, 0xF7, 0x44, 0xFD, 0x5C, 0xFA, 0x1C, 0x02, 0x8B, 0x05, 
0x20, 0x0C, 0x02, 0x0D, 0xC4, 0x14, 0x66, 0x11, 0x7B, 0x1A, 0xE6, 0x17, 0xFC, 0x2C, 0x81, 0x23, 
0xD5, 0x1E, 0x56, 0x3E, 0x42, 0x35, 0xB5, 0x31, 0x8E, 0x39, 0xF1, 0x5D, 0x27, 0x5B, 0x9A, 0x64, 
0x5C, 0x6D, 0x18, 0x5F, 0xB7, 0x52, 0x12, 0x50, 0x8A, 0x3D, 0xC0, 0x46, 0x1C, 0x38, 0x29, 0x32, 
0xD3, 0x43, 0x60, 0x25, 0xFC, 0x3C, 0x7D, 0x33, 0xA8, 0x38, 0x48, 0x31, 0x6A, 0x2D, 0x9E, 0x43, 
0x6D, 0x44, 0x8D, 0x48, 0x20, 0x4B, 0xEB, 0x40, 0x55, 0x4D, 0x17, 0x4A, 0xC9, 0x54, 0xBC, 0x5E, 
0xFE, 0x50, 0xCF, 0x60, 0x11, 0x55, 0x75, 0x5C, 0xBE, 0x48, 0x81, 0x47, 0x20, 0x45, 0x6C, 0x42, 
0x5C, 0x47, 0x58, 0x41, 0x1A, 0x4A, 0xE5, 0x49, 0x25, 0x4F, 0x9F, 0x55, 0xAD, 0x57, 0xC6, 0x56, 
0x87, 0x57, 0x26, 0x52, 0xFF, 0x57, 0x0B, 0x5A, 0xC5, 0x5F, 0x6E, 0x57, 0x5B, 0x4D, 0x8A, 0x4B, 
0x41, 0x46, 0x3E, 0x49, 0x51, 0x39, 0x0D, 0x3E, 0x37, 0x4B, 0x28, 0x40, 0x10, 0x42, 0xF0, 0x45, 
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
};
