joranderaaff/portal-turret-v4/src/motion/Gantry.cpp

#include "motion/Gantry.h"

static const float kGravity = 9.81f;
static const float kTippedMinZ = 0.5f * kGravity;
static const float kStandingMinZ = 0.8f * kGravity;

namespace {
constexpr float REST_AMPLITUDE = 0.05f;
constexpr ulong IMPULSE_DETECTION_UPDATE_INTERVAL = 50;
} // namespace

Gantry::Gantry(Settings &_settings, Light &light, Audio &audio, ADXL &_motion) : settings(_settings), motion(_motion), wingLeft(_settings, light, audio, PIN_WING_LEFT, PIN_GUN_LEFT, PIN_HALL_LEFT), wingRight(_settings, light, audio, PIN_WING_RIGHT, PIN_GUN_RIGHT, PIN_HALL_RIGHT) {
}

bool Gantry::IsTippedOver() {
  if (enableTiltShutdown) {
    return motion.GetSmoothAcceleration().z < kTippedMinZ;
  }
  return false;
}

bool Gantry::IsPickedUp() {
  return pickupImpulseDetected;
}

bool Gantry::IsAtRest() {
  return impulseDetection.GetCurrentAmplitudeZ() < REST_AMPLITUDE && motion.GetSmoothAcceleration().z > kStandingMinZ;
}

void Gantry::Initialize() {
  ESP32PWM::allocateTimer(0);
  ESP32PWM::allocateTimer(1);
  ESP32PWM::allocateTimer(2);
  ESP32PWM::allocateTimer(3);

  enableTiltShutdown = settings.GetBool(SettingId::EnableTiltShutdown);

  angleOffsetX = settings.GetFloat(SettingId::AngleOffsetX);
  angleOffsetZ = settings.GetFloat(SettingId::AngleOffsetZ);
  maxAngleX = settings.GetFloat(SettingId::AngleMaxX);
  maxAngleZ = settings.GetFloat(SettingId::AngleMaxZ);

  delay(100);

  servoRotateX.attach(PIN_ROTATE_X);
  SetRotationX(0, true);

  servoRotateZ.attach(PIN_ROTATE_Z);
  SetRotationZ(0, true);

  wingLeft.Initialize();
  wingRight.Initialize();

  wingLeft.Close();
  wingRight.Close();
}

void Gantry::SetRotationX(float angle, bool force) {
  if (closeWingsRequested) {
    return;
  }
  angle = constrain(angle, -maxAngleX, maxAngleX);
  targetAngleX = 90 + (angle + angleOffsetX) * X_AXIS_GEAR_RATIO;
  servoRotateX.write(targetAngleX, force);
}

void Gantry::SetRotationZ(float angle, bool force) {
  if (closeWingsRequested) {
    return;
  }
  angle = constrain(angle, -maxAngleZ, maxAngleZ);
  targetAngleZ = 90 - (angle + angleOffsetZ) * Z_AXIS_GEAR_RATIO;
  servoRotateZ.write(targetAngleZ, force);
}

void Gantry::Update(ulong deltaTime) {
  if (closeWingsRequested) {
    if (millis() > closeWingsTime) {
      closeWingsRequested = false;
      wingLeft.Close();
      wingRight.Close();
    }
  }
  
  servoRotateX.Update(deltaTime);
  servoRotateZ.Update(deltaTime);

  wingLeft.Update(deltaTime);
  wingRight.Update(deltaTime);

  timeSinceLastImpulseUpdate += deltaTime;
  if (timeSinceLastImpulseUpdate > IMPULSE_DETECTION_UPDATE_INTERVAL) {
    timeSinceLastImpulseUpdate -= IMPULSE_DETECTION_UPDATE_INTERVAL;
    pickupImpulseDetected = impulseDetection.AddSample(motion.GetSmoothAcceleration().z);
  }
}

Wing &Gantry::GetWingLeft() { return wingLeft; }

Wing &Gantry::GetWingRight() { return wingRight; }

void Gantry::CloseWings() {
  if (closeWingsRequested) {
    return;
  }
  SetRotationX(0, false);
  SetRotationZ(0, false);
  closeWingsRequested = true;
  closeWingsTime = millis() + 750;
}

void Gantry::Halt() {
  closeWingsRequested = false;
  servoRotateX.Stop();
  servoRotateZ.Stop();
  wingLeft.Halt();
  wingRight.Halt();
}

void Gantry::SetServoRaw(GantryServo servo, int angle) {
  angle = constrain(angle, 0, 180);
  switch (servo) {
  case GantryServo::RotateX:
    servoRotateX.write(angle, true);
    break;
  case GantryServo::RotateZ:
    servoRotateZ.write(angle, true);
    break;
  case GantryServo::WingLeft:
    wingLeft.SetRaw(angle);
    break;
  case GantryServo::WingRight:
    wingRight.SetRaw(angle);
    break;
  case GantryServo::GunLeft:
    wingLeft.GetGun().SetRaw(angle);
    break;
  case GantryServo::GunRight:
    wingRight.GetGun().SetRaw(angle);
    break;
  }
}

void Gantry::OpenWings() {
  wingLeft.Open();
  wingRight.Open();
  closeWingsRequested = false;
}
