joranderaaff/portal-turret-v4/src/motion/Gun.cpp

#include "Gun.h"

const int EXTEND_ANGLE = 160;

Gun::Gun(Settings &_settings, Light &_light, Audio &_audio, int servoPinIn) : settings(_settings), light(_light), audio(_audio) {
  servoPin = servoPinIn;
}

void Gun::Initialize() {
  servo.setPeriodHertz(50); // standard 50 hz servo
  servo.attach(servoPin, 500, 2400);

  heatBrightness = settings.GetInt(SettingId::HeatBrightness);
  barrelCooldownDuration = settings.GetFloat(SettingId::BarrelCooldownDuration);
  barrelHeatupDuration = settings.GetFloat(SettingId::BarrelHeatupDuration);

  shotBrightness = settings.GetInt(SettingId::ShotBrightness);
  shotDuration = settings.GetInt(SettingId::ShotDuration);
  Retract();
}

void Gun::Update(ulong deltaTime) {
  float deltaTimeSeconds = (float) deltaTime / 1000.0f;
  float shotBrightnessEnvelope = 0.0f;
  if (firing) {
    if (barrelHeatupDuration == 0.0f) {
      barrelHeat = 1.0f;
    } else {
      barrelHeat += deltaTimeSeconds / barrelHeatupDuration;
    }
    uint phaseOffset = servoPin == PIN_GUN_LEFT ? 0 : shotDuration / 2;

    uint prevShotIndex = (firingTime + phaseOffset) / shotDuration;
    firingTime += deltaTime;
    uint shotIndex = (firingTime + phaseOffset) / shotDuration;

    uint currentShotPhase = (firingTime + phaseOffset) % shotDuration;

    if (shotIndex > prevShotIndex) {
      audio.QueueLayeredAudioCommand(LayeredAudioId::Trigger);
    }

    // Move phase of one gun half the duration
    float p = (float)currentShotPhase / shotDuration;
    float attack = 0.20f;
    // https://graphtoy.com/?f1(x,t)=1-max((x-0.2)/(1-0.2),(x-0.2)*-(1/0.2))&v1=true&f2(x,t)=&v2=true&f3(x,t)=&v3=false&f4(x,t)=&v4=false&f5(x,t)=&v5=false&f6(x,t)=&v6=false&grid=1
    shotBrightnessEnvelope = 1.0f - max((p - attack) / (1.0f - attack), (p - attack) * -(1.0f / attack));

    float extendAngle = servoPin == PIN_GUN_LEFT ? EXTEND_ANGLE : 180.0f - EXTEND_ANGLE;
    float angle = Lerp(90, extendAngle, shotBrightnessEnvelope);

    servo.write(angle);
  } else {
    if (barrelCooldownDuration == 0.0f) {
      barrelHeat = 0.0f;
    } else {
      barrelHeat -= deltaTimeSeconds / barrelCooldownDuration;
    }
  }

  shotBrightnessEnvelope = Clamp(shotBrightnessEnvelope, 0.0f, 1.0f);
  barrelHeat = Clamp(barrelHeat, 0.0f, 1.0f);

  int maxBrightness = max(shotBrightnessEnvelope * shotBrightness, barrelHeat * heatBrightness);

  if (servoPin == PIN_GUN_LEFT) {
    light.SetLeftGunLight(HeatColor(maxBrightness));
  } else {
    light.SetRightGunLight(HeatColor(maxBrightness));
  }
}

void Gun::Extend() {
  if (servoPin == PIN_GUN_LEFT) {
    servo.write(EXTEND_ANGLE);
  } else {
    servo.write(180 - EXTEND_ANGLE);
  }
}

void Gun::Retract() {
  servo.write(90);
}

void Gun::StartFiring() {
  firingTime = 0;
  firing = true;
  audio.QueueLayeredAudioCommand(LayeredAudioId::Trigger);
}

void Gun::SetRaw(int angle) {
  firing = false;
  servo.write(angle);
}

void Gun::StopFiring() {
  firing = false;
  if (servoPin == PIN_GUN_LEFT) {
    light.SetLeftGunLight(CRGB::Black);
  } else {
    light.SetRightGunLight(CRGB::Black);
  }
  Retract();
}
