joranderaaff/portal-turret-v4/src/web/TurretWebServer.h

#pragma once

#include "WiFi.h"
#include <atomic>
#include "settings/Settings.h"
#include <ESPAsyncWebServer.h>
#include <Turret.h>
#include "states/DiagnoseCommand.h"
#include "states/RemoteCommand.h"

enum WebSocketMessage : uint8_t {
  MESSAGE_RADAR = 0x01,
  MESSAGE_MOTION = 0x02,
  MESSAGE_ORIENTATION = 0x03,
  // 0x04 is the gantry message.
  MESSAGE_LOG = 0x05,
  MESSAGE_HALL = 0x06,
};

// Log message layout:
//   u8  MESSAGE_LOG
//   u8  LogLevel (0 info, 1 warning, 2 error)
//   UTF-8 text (not terminated)

// Radar message layout (little endian):
//   u8  MESSAGE_RADAR
//   u8  target count (n)
//   n x { u8 id, u8 flags (bit0 available, bit1 isMoving),
//         i16 x, i16 y, i16 previousX, i16 previousY, i16 speed, u16 resolution }
// Positions are in mm.
constexpr size_t RADAR_TARGET_BYTES = 14;
constexpr size_t RADAR_MESSAGE_BYTES = 2 + TRACK_COUNT * RADAR_TARGET_BYTES;

// Motion message layout (little endian):
//   u8  MESSAGE_MOTION
//   3 x f32 acceleration x, y, z in m/s^2
constexpr size_t MOTION_MESSAGE_BYTES = 1 + 6 * sizeof(float);

// Orientation message layout (little endian):
//   u8  MESSAGE_ORIENTATION
//   2 x f32 roll (-180..180), pitch (-90..90) in degrees
constexpr size_t ORIENTATION_MESSAGE_BYTES = 1 + 2 * sizeof(float);

// Hall message layout (little endian), sent when a value changes and at least once a second:
//   u8  MESSAGE_HALL
//   2 x { u16 raw ADC value, u8 HallState (0 closed, 1 between, 2 open) } for the left, then right wing
constexpr size_t HALL_MESSAGE_BYTES = 1 + 2 * 3;

class TurretWebServer {
public:
  TurretWebServer();
  void Initialize(Turret &turret, Settings &settings);
  void Update(ulong deltaTime);
  // Sends a finished log message to all websocket clients, see logging/Logger.h.
  void SendLog(LogLevel level, const char *message);
  // True once after the web UI asked to start the turret.
  bool ConsumeStartRequest() { return startRequested.exchange(false); }
  // Pops the next diagnose action requested by the web UI, if any.
  bool ConsumeDiagnoseCommand(DiagnoseCommand &command) { return xQueueReceive(diagnoseQueue, &command, 0) == pdTRUE; }
  // Pops the next remote control action requested by the web UI, if any.
  bool ConsumeRemoteCommand(RemoteCommand &command) { return xQueueReceive(remoteQueue, &command, 0) == pdTRUE; }
  AsyncWebServer webServer;

private:
  void SendRadar();
  void SendMotion();
  void SendOrientation();
  void SendHall();
  void QueueDiagnose(AsyncWebServerRequest *request, const DiagnoseCommand &command);
  void QueueRemote(AsyncWebServerRequest *request, const RemoteCommand &command);

  AsyncWebSocket socket;
  Settings *settings;
  Turret *turret;
  ulong timeSinceRadarSend = 0;
  ulong timeSinceHallSend = 0;
  uint8_t lastHallMessage[HALL_MESSAGE_BYTES] = {};
  std::atomic<bool> startRequested{false};
  QueueHandle_t diagnoseQueue = NULL;
  QueueHandle_t remoteQueue = NULL;
};
