joranderaaff/portal-turret-v4/src/motion/Gantry.h

#pragma once

#include "Arduino.h"
#include "Wing.h"
#include "helpers/Math.h"
#include "light/Light.h"
#include "motion/IntertiaServo.h"
#include "pins.h"
#include "sensors/ADXL.h"
#include "settings/Settings.h"

// Every servo in the turret, for raw access from the diagnose page.
enum class GantryServo {
  RotateX,
  RotateZ,
  WingLeft,
  WingRight,
  GunLeft,
  GunRight
};

class Gantry {
public:
  Gantry(Settings &settings, Light &light, Audio &audio, ADXL &motion);
  void Initialize();
  void Update(ulong deltaTime);
  void SetRotationX(float angle, bool force);
  void SetRotationZ(float angle, bool force);
  void OpenWings();
  void CloseWings();
  // Stops all movement and firing, leaving everything where it is.
  void Halt();
  // Writes a servo directly (0..180), bypassing gear ratios, offsets and limits.
  void SetServoRaw(GantryServo servo, int angle);
  Wing &GetWingLeft();
  Wing &GetWingRight();
  // Level checks on the smoothed acceleration (no hysteresis yet).
  bool IsTippedOver();
  bool IsPickedUp();
  bool IsAtRest();

private:
  ulong closeWingsTime = 0;
  bool closeWingsRequested = false;
  
  float X_AXIS_GEAR_RATIO = 75.0 / 17.0;
  float Z_AXIS_GEAR_RATIO = 30.0 / 15.0;
  float angleOffsetX = 0;
  float angleOffsetZ = 0;
  float maxAngleX = 90;
  float maxAngleZ = 90;

  float currentAngleX;
  float targetAngleX;

  float currentAngleZ;
  float targetAngleZ;

  bool enableTiltShutdown = false;

  Wing wingLeft;
  Wing wingRight;
  InertiaServo servoRotateX;
  InertiaServo servoRotateZ;
  Settings &settings;
  ADXL &motion;

  ulong timeSinceLastImpulseUpdate = 0;
  bool pickupImpulseDetected;
  ImpulseDetection impulseDetection;
};
