joranderaaff/portal-turret-v4/(commit log)

2026-08-09 Boilerplate stuff
    More first stage code for movement
    Removed double audio class
    Made Lights global
    Added ADXL code
2026-08-11 Servo tests
2026-08-11 Moved Turret out of Setup and in global scope to prevent memory issues
    [main.cpp]
2026-08-26 Made lolin s3 mini default and added testing movement for wings
2026-09-01 Added gerber files
2026-09-06 A lot of stuff
    Added OTA updates, first audio test with mp3, moving of guns and wings, activating LEDs
2026-09-19 Added ratios to translate from world angle to servo angle
2026-09-28 More work on firing flow
2026-09-29 Added radar page, added better flow, added target tracker
2026-09-29 Added reset settings button. Added setting for delay after disengage.
    [DisengageState.cpp, Settings.cpp, Settings.h, TurretWebServer.cpp]
2026-10-02 Added graphs for accelerometer graphs
2026-10-02 Made scope more specific. Fixed smoothing of accel.
    [Gantry.cpp, Gantry.h, Gun.cpp, Gun.h, Motion.cpp, Motion.h, Radar.cpp, Radar.h]
2026-10-04 Working on interupts by tilt/shake, added Inertia servo for smooth movement.
2026-10-09 Center LED now properly fades in/out at shutdown/boot
2026-10-12 Fixed barrel heat. Removed fixed IP from platform.io. Fixed uploading LittleFS with OTA
2026-10-16 Added safety in timing when closing wings
2026-10-16 Antenna modeled, brought back the switch mount spot
2026-10-19 Added Gerber and latest STEP
2026-10-19 Added HALL readouts for diagnose page
2026-10-19 Updated Z-axis build image
2026-10-20 Fixed LED not working in new FastLED version. Wings close on boot.
2026-10-25 Wiring explanation for LEDs
2026-10-26 Added explanation about the LED harness
2026-10-26 More info on how to wire the LED ring
2026-10-31 Info about gantry
2026-11-01 Added plastic as BOM item
2026-11-12 Added caps to BOM
2026-11-12 Changed BOM to reflect Wemos S3 Mini
2026-11-12 Explain missing components on PCB
2026-11-12 Updated BOM
